2468shrm/openmv_can_eth_shield/openmv_can_shield.kicad_pcb

## KiCad design openmv_can_shield.kicad_pcb (2024-02-28)

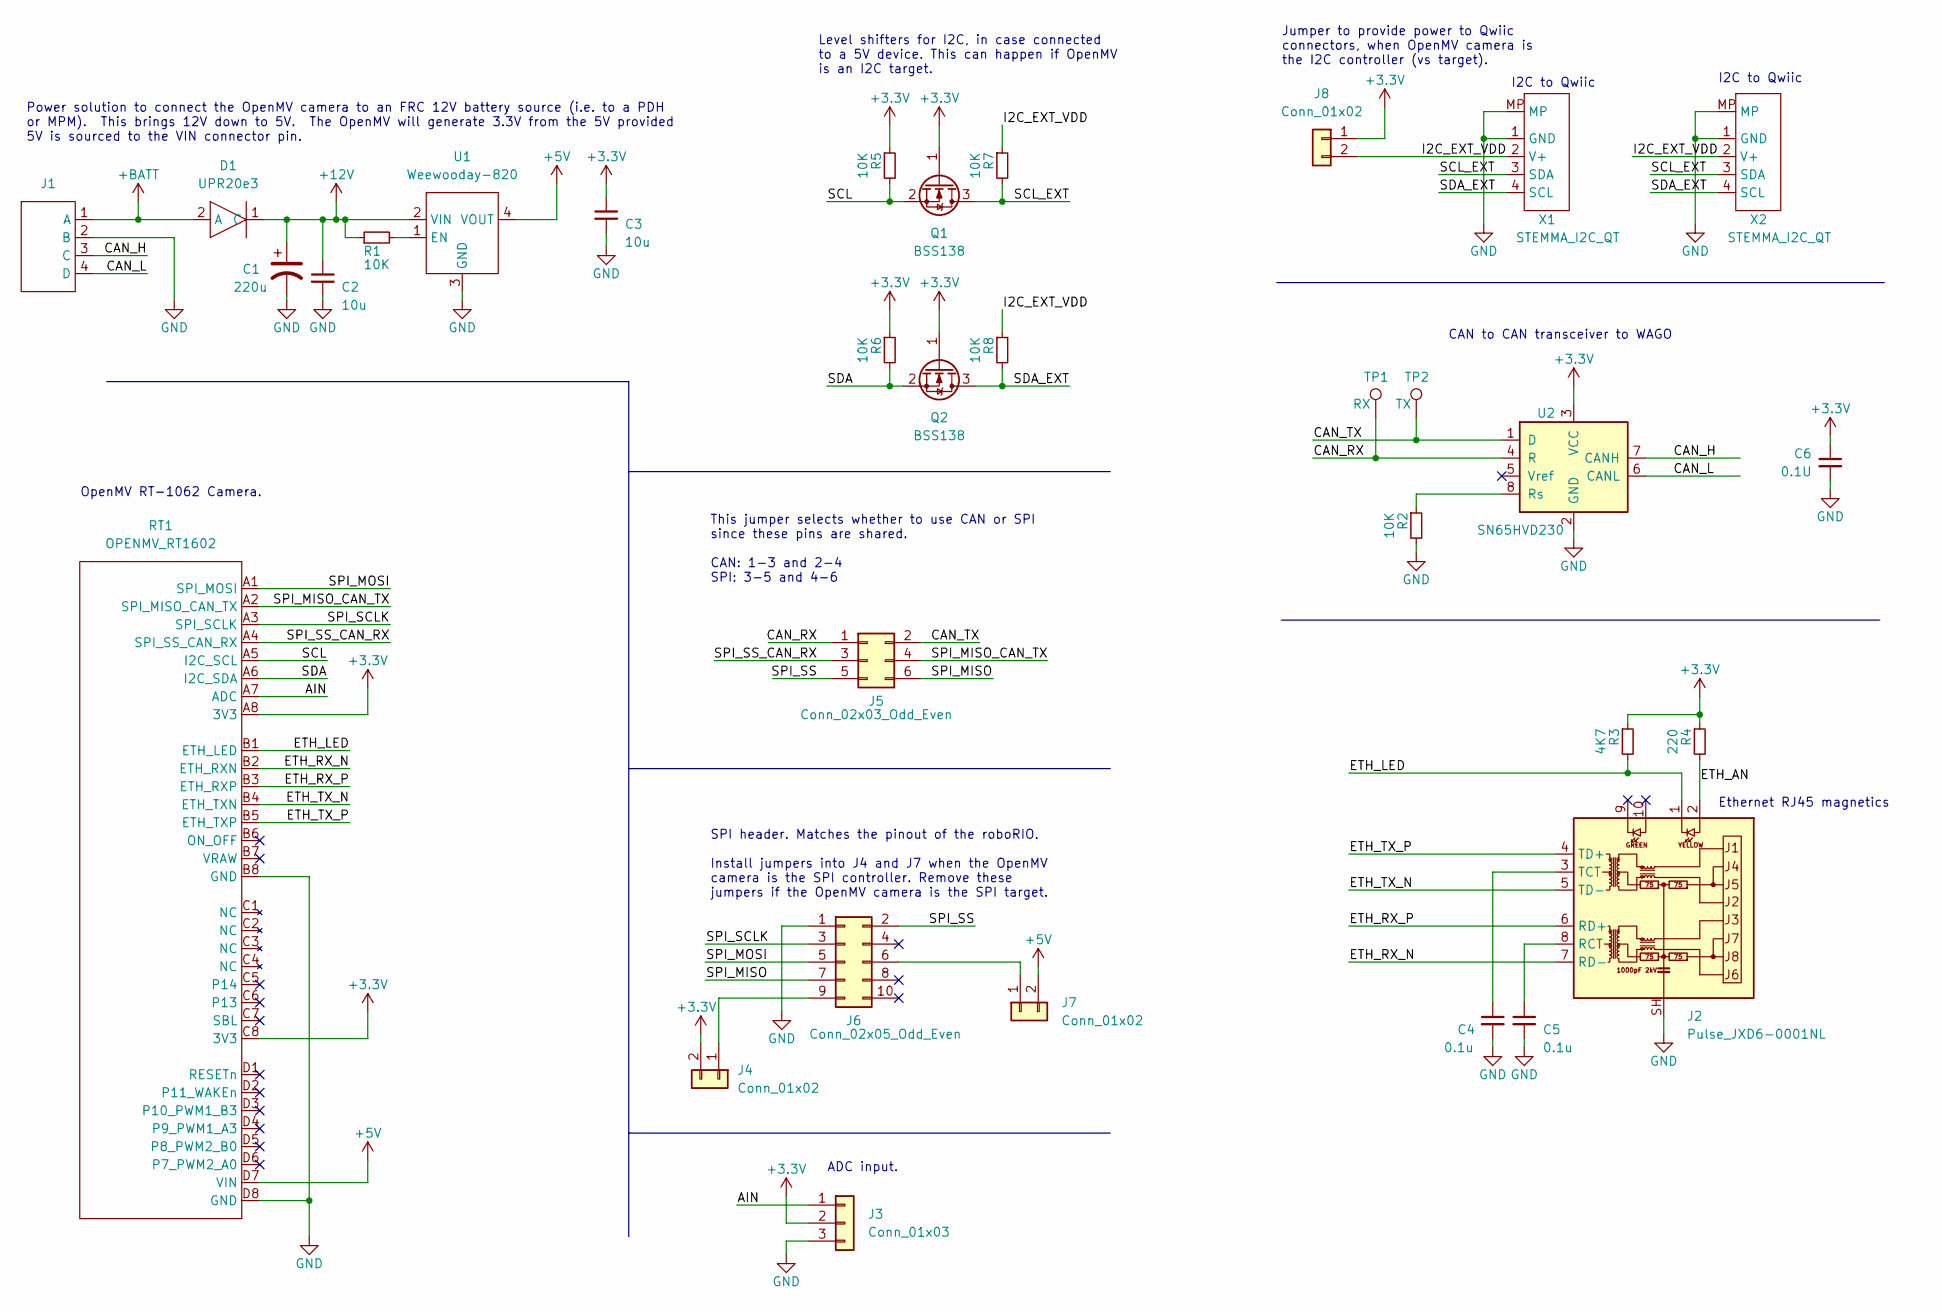
[picture p1: schematic openmv_can_shield.kicad_sch]

Parts:
C1: 220u; CP_Elec_6.3x7.7; LCSC C340767
C2, C3: 10u; C_1206_3216Metric; LCSC C14860
C4, C5: 0.1u; C_1206_3216Metric; LCSC C14860
C6: 0.1U; C_1206_3216Metric
D1: UPR20e3; DO-216
J1: WAGO_250-204; WAGO 250-204
J2: Pulse_JXD6-0001NL; RJ45_Pulse_JXD6-0001NL_Horizontal
J3: Conn_01x03; PinHeader_1x03_P2.54mm_Vertical
J4, J7, J8: Conn_01x02; PinHeader_1x02_P2.54mm_Vertical
J5: Conn_02x03_Odd_Even; PinHeader_2x03_P2.54mm_Vertical
J6: Conn_02x05_Odd_Even; PinHeader_2x05_P2.54mm_Vertical
Q1, Q2: BSS138; SOT-23
R1, R2, R5, R6, R7, R8: 10K; R_1206_3216Metric
R3: 4K7; R_1206_3216Metric
R4: 220; R_1206_3216Metric
RT1: OPENMV_RT1602; RT1062
TP1: RX; TestPoint_Pad_D1.5mm
TP2: TX; TestPoint_Pad_D1.5mm
U1: Weewooday-820
U2: SN65HVD230; SOIC-8_3.9x4.9mm_P1.27mm
X1, X2: STEMMA_I2C_QT; JST_SH_BM04B-SRSS-TB_1x04-1MP_P1.00mm_Vertical; LCSC C545725

Connections:
+3.3V: C3.1, C6.1, J3.2, J4.2, J8.1, Q1.1 (G), Q2.1 (G), R3.1, R4.1, R5.1, R6.1, RT1.A8 (3V3), RT1.C8 (3V3), U2.3 (VCC)
+5V: J7.2, RT1.D7 (VIN), U1.4 (VOUT)
+12V: C1.1, C2.1, D1.1 (C), R1.1, U1.2 (VIN)
+BATT: D1.2 (A), J1.1 (A)
/AIN: J3.1, RT1.A7 (ADC)
/CAN_H: J1.3 (C), U2.7 (CANH)
/CAN_L: J1.4 (D), U2.6 (CANL)
/CAN_RX: J5.1, TP1.1, U2.4 (R)
/CAN_TX: J5.2, TP2.1, U2.1 (D)
/ETH_AN: J2.2, R4.2
/ETH_LED: J2.1, R3.2, RT1.B1 (ETH_LED)
/ETH_RX_N: J2.7 (RD-), RT1.B2 (ETH_RXN)
/ETH_RX_P: J2.6 (RD+), RT1.B3 (ETH_RXP)
/ETH_TX_N: J2.5 (TD-), RT1.B4 (ETH_TXN)
/ETH_TX_P: J2.4 (TD+), RT1.B5 (ETH_TXP)
/I2C_EXT_VDD: J8.2, R7.1, R8.1, X1.2 (V+), X2.2 (V+)
/SCL: Q1.2 (S), R5.2, RT1.A5 (I2C_SCL)
/SCL_EXT: Q1.3 (D), R7.2, X1.3 (SDA), X2.3 (SDA)
/SDA: Q2.2 (S), R6.2, RT1.A6 (I2C_SDA)
/SDA_EXT: Q2.3 (D), R8.2, X1.4 (SCL), X2.4 (SCL)
/SPI_MISO: J5.6, J6.7
/SPI_MISO_CAN_TX: J5.4, RT1.A2 (SPI_MISO_CAN_TX)
/SPI_MOSI: J6.5, RT1.A1 (SPI_MOSI)
/SPI_SCLK: J6.3, RT1.A3 (SPI_SCLK)
/SPI_SS: J5.5, J6.2
/SPI_SS_CAN_RX: J5.3, RT1.A4 (SPI_SS_CAN_RX)
GND: C1.2, C2.2, C3.2, C4.2, C5.2, C6.2, J1.2 (B), J2.SH, J3.3, J6.1, R2.2, RT1.B8 (GND), RT1.D8 (GND), U1.3 (GND), U2.2 (GND), X1.1 (GND), X1.MP, X2.1 (GND), X2.MP
unnamed: C4.1, J2.3 (TCT)
unnamed: C5.1, J2.8 (RCT)
unnamed: J4.1, J6.9
unnamed: J6.6, J7.1
unnamed: R1.2, U1.1 (EN)
unnamed: R2.1, U2.8 (Rs)

Notes on the sheet:
ADC input.
Ethernet RJ45 magnetics
This jumper selects whether to use CAN or SPI since these pins are shared. CAN: 1-3 and 2-4 SPI: 3-5 and 4-6
Level shifters for I2C, in case connected to a 5V device. This can happen if OpenMV is an I2C target.
CAN to CAN transceiver to WAGO
OpenMV RT-1062 Camera.
SPI header. Matches the pinout of the roboRIO. Install jumpers into J4 and J7 when the OpenMV camera is the SPI controller. Remove these jumpers if the OpenMV camera is the SPI target.
Power solution to connect the OpenMV camera to an FRC 12V battery source (i.e. to a PDH or MPM). This brings 12V down to 5V. The OpenMV will generate 3.3V from the 5V provided 5V is sourced to the VIN connector pin.
Jumper to provide power to Qwiic connectors, when OpenMV camera is the I2C controller (vs target).
I2C to Qwiic

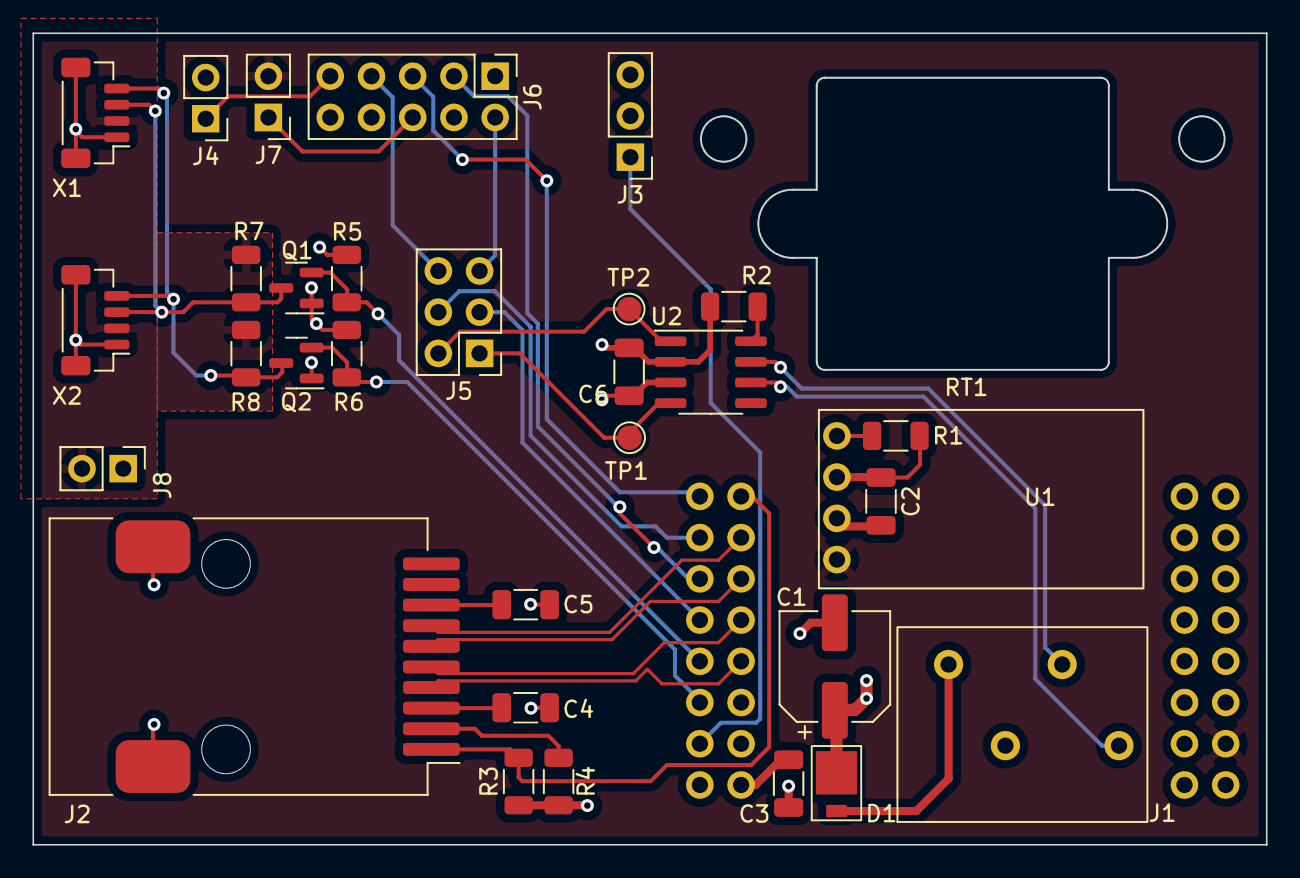
[picture p2: board openmv_can_shield.kicad_pcb from above]

Board: 4 copper layers, 76.0 x 50.0 mm, 32 parts (0 on the bottom side), 33 nets.
