2468shrm/openmv_can_eth_shield/(commit log)

2024-02-24 PCB files
    [openmv_can_shield.kicad_pcb, openmv_can_shield.kicad_sch]
2024-02-28 Updated schematics and layout to have complete, DRC clean layout, Gerbers not updated
    [openmv_can_shield.kicad_pcb, openmv_can_shield.kicad_sch]
